RUBINQI/FOC_drv8305-STM32F407/README.md

# FOC_DRV8305&STM32F407
FOC project with AI Coding（vibe coding），use drv8305 to drive NMOS FETS，MCU is STM32F407VET6
PCB is printed by JLC(4 layers)
