RUBINQI/FOC_drv8305-STM32F407/Hardware/pcb/3D_PCB_bottom.png

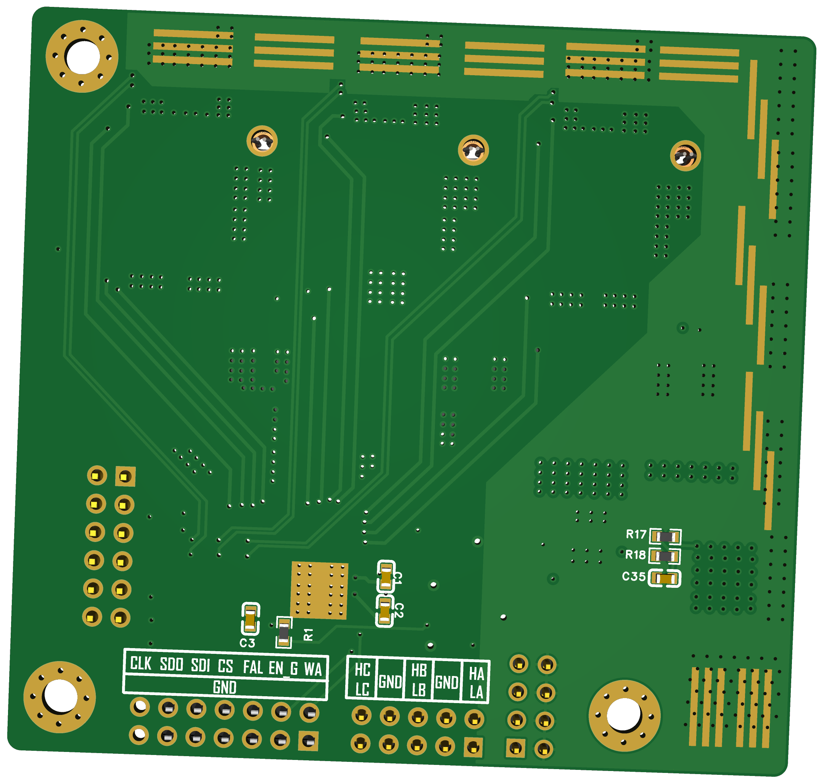
Hardware/pcb/3D_PCB_bottom.png
