RUBINQI/FOC_drv8305-STM32F407/Hardware/pcb/PCB_PCB1_2026-03-12.pdf

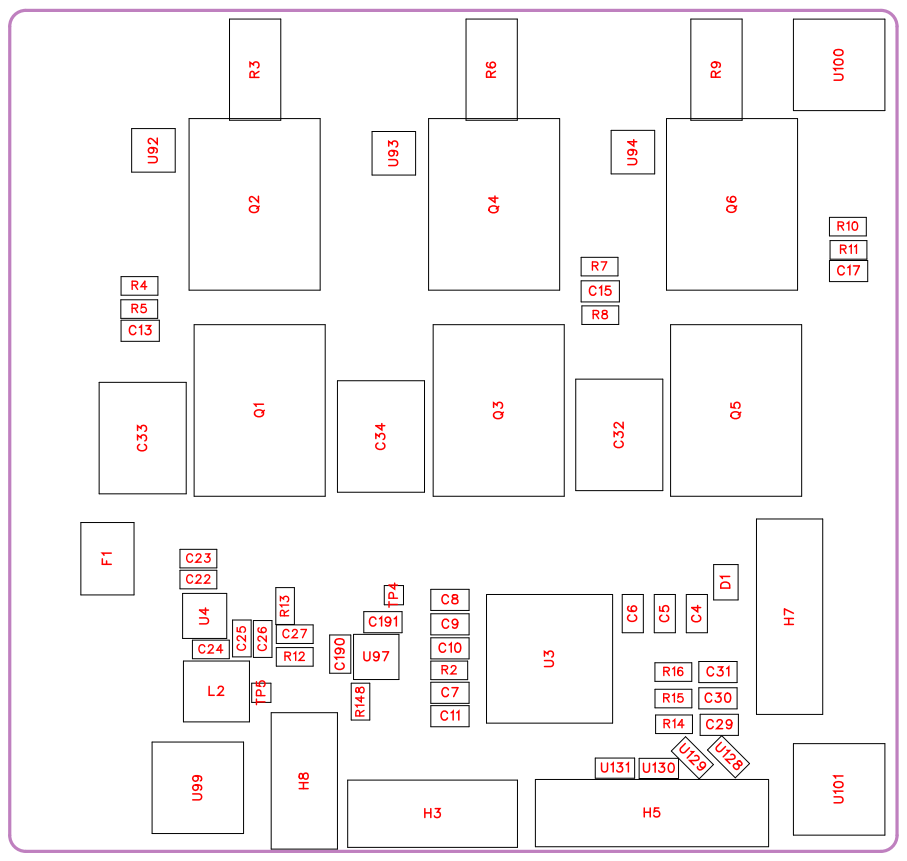
[picture p3: page 1]

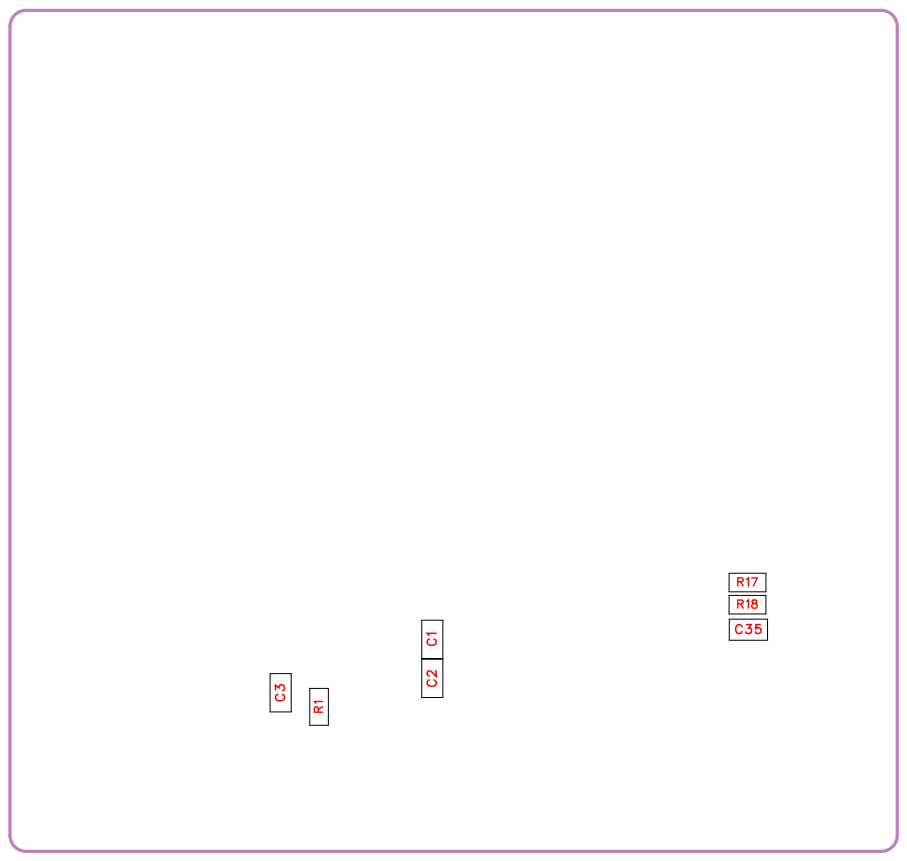
[picture p4: page 2]

No. | Quantity | Comment | Designator | Footprint | Value | Manufacturer Part | Manufacturer | Supplier Part | Supplier
1 | 2 | 470pF | C1,C2 | C0603 | 470pF
2 | 8 | 1uF | C3,C7,C8,C11,C13,C15,C1 7,C35 | C0603 | 1uF
3 | 3 | 1nF | C4,C5,C6 | C0603 | 1nF
4 | 4 | 2.2uF | C9,C29,C30,C31 | C0603 | 2.2uF
5 | 1 | 4.7uF | C10 | C0603 | 4.7uF
6 | 2 | 22u | C22,C26 | C0603
7 | 3 | 100n | C23,C24,C25 | C0603
8 | 1 | 220p | C27 | C0603
9 | 3 | 固态电容220 uF/10V6.3*5. 4 | C32,C33,C34 | CAP-SMD_B D6.3-L6.6-W 6.6-LS7.2-FD | | 固态电容220 uF/10V6.3*5. 4 | | C990000173 6 | LCSC
10 | 2 | 1u | C190,C191 | C0603 | 1u
11 | 1 | TPD4E02B0 4QDQARQ1 | D1 | USON-10_L2 .5-W1.0-P0.5 0-BL | | TPD4E02B0 4QDQARQ1 | TI(德州仪器) | C1973193 | LCSC
12 | 1 | BSMD1812-2 00-30V | F1 | F1812 | | BSMD1812-2 00-30V | BHFUSE(佰 宏) | C960026 | LCSC
13 | 1 | HDR-F_2.54 _2x5 | H3 | HDR-TH_10 P-P2.54-V-F-R2-C5-S2.54 | | | | C92270
14 | 1 | HDR-F_2.54 _2x7 | H5 | HDR-TH_14 P-P2.54-V-F-R2-C6-S2.54 | | | | C36191
15 | 1 | HDR-F_2.54 _2x6 | H7 | HDR-TH_12 P-P2.54-V-M -R2-C6-S2.5 4
16 | 1 | HDR-F_2.54 _2x4 | H8 | HDR-TH_8P-P2.54-V-F-R 2-C4-S2.54-1 | | | | C92271
17 | 1 | 4.7uH | L2 | IND-SMD_L4 .6-W4.2_042 0_4.7UH | 4.7uH
18 | 6 | HYG006N04 LS1TA | Q1,Q2,Q3,Q4,Q5,Q6 | TOLL-8_L10. 4-W9.9-P1.2 0-LS11.7-BL | | HYG006N04 LS1TA | HUAYI(华羿 微) | C2982928 | LCSC
19 | 1 | 10K | R1 | R0603 | 10K
20 | 1 | 100 | R2 | R0603 | 100
21 | 3 | 10m | R3,R6,R9 | R2512 | 10m | RLM25FEER 010 | 大毅科技 | C192580 | LCSC
22 | 4 | 24.9k | R4,R7,R10,R17 | R0603 | 24.9k
23 | 4 | 4.99k | R5,R8,R11,R18 | R0603 | 4.99k
24 | 1 | 73.2k | R12 | R0603
25 | 1 | 10k | R13 | R0603

26 | 3 | 56 | R14,R15,R16 | R0603 | 56
27 | 1 | 100k | R148 | R0603 | 100k
28 | 2 | 测试点 | TP4,TP5 | TP
29 | 1 | DRV83053Q PHPRQ1 | U3 | HTQFP-48_L 7.0-W7.0-P0. 50-LS9.0-BL-EP5.1 | | DRV83053Q PHPRQ1 | TI(德州仪器 ) | C701777 | LCSC
30 | 1 | RY9121 | U4 | TSOT-23-6_ L2.9-W1.6-P 0.95-LS2.8-B R | | RY9121 | RYCHiP(蕊源 ) | C2887854 | LCSC
31 | 3 | TP-黄色测试 点 | U92,U93,U94 | TESTPOINT-TH_BD3.2 | | TP-黄色测试 点 | | C990000742 2 | LCSC
32 | 1 | RT9013 | U97 | RT9013
33 | 3 | 定位孔 | U99,U100,U101 | M3定位孔
34 | 4 | 测试环5015 | U128,U129,U130,U131 | 测试环5015

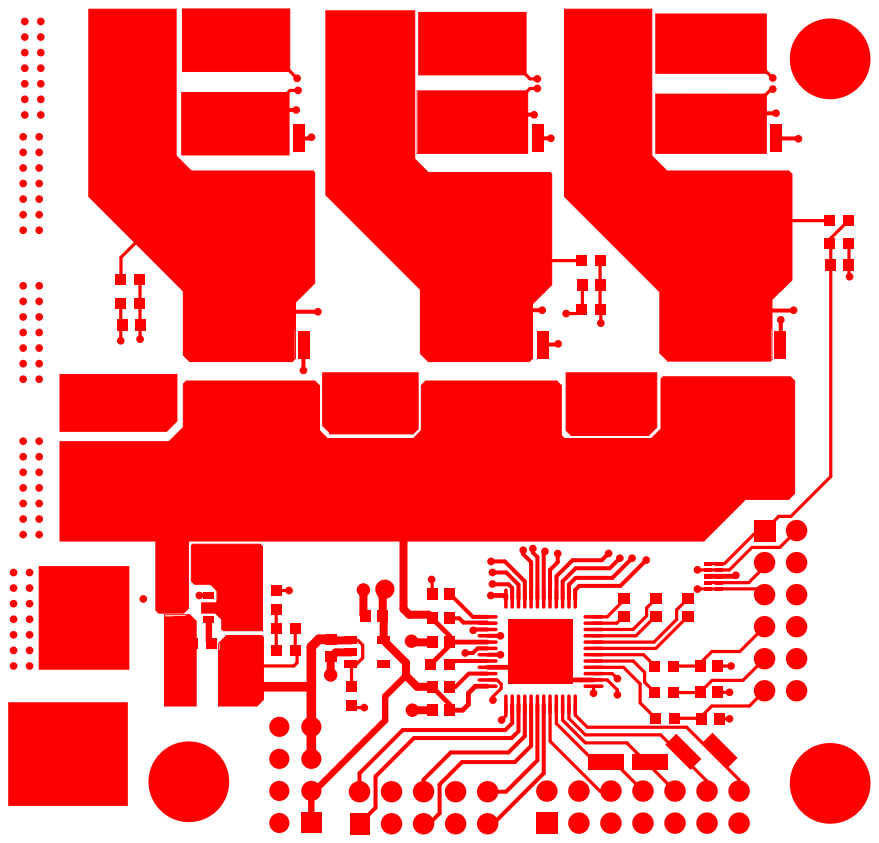
[picture p5: page 5]

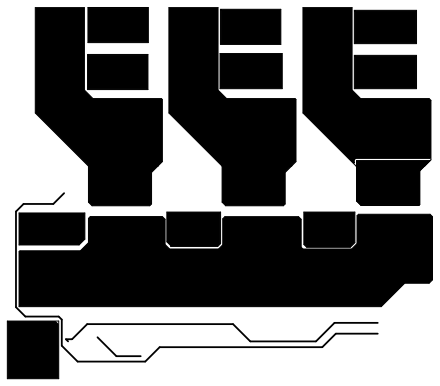
[picture p6: figure]
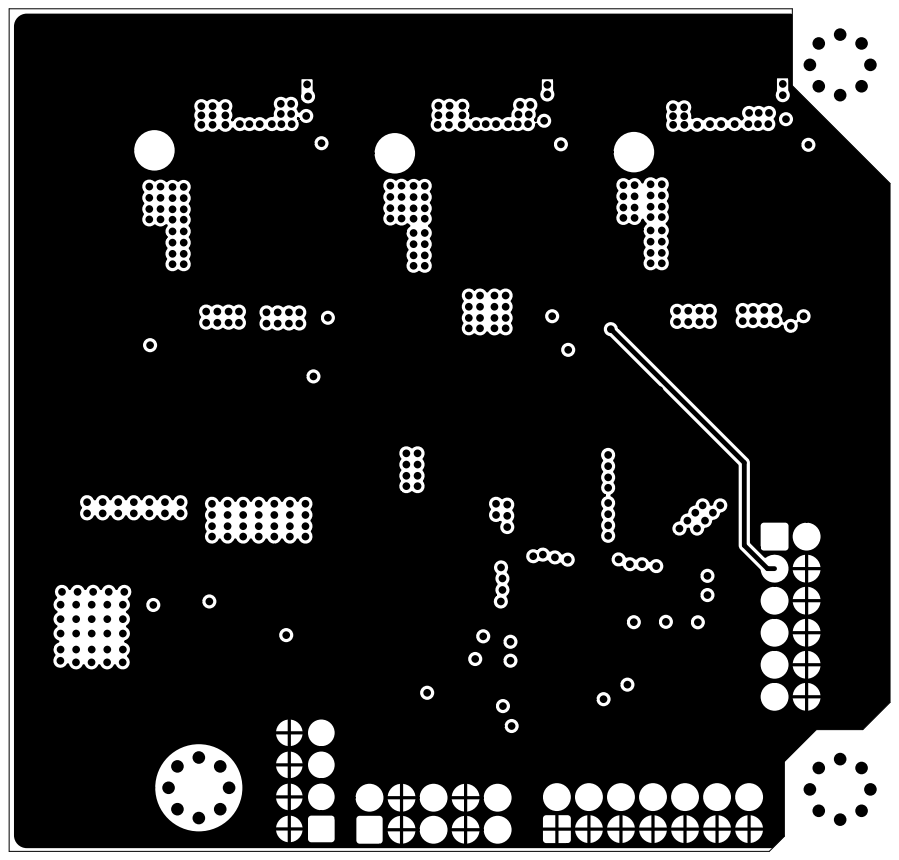
[picture p7: page 7]

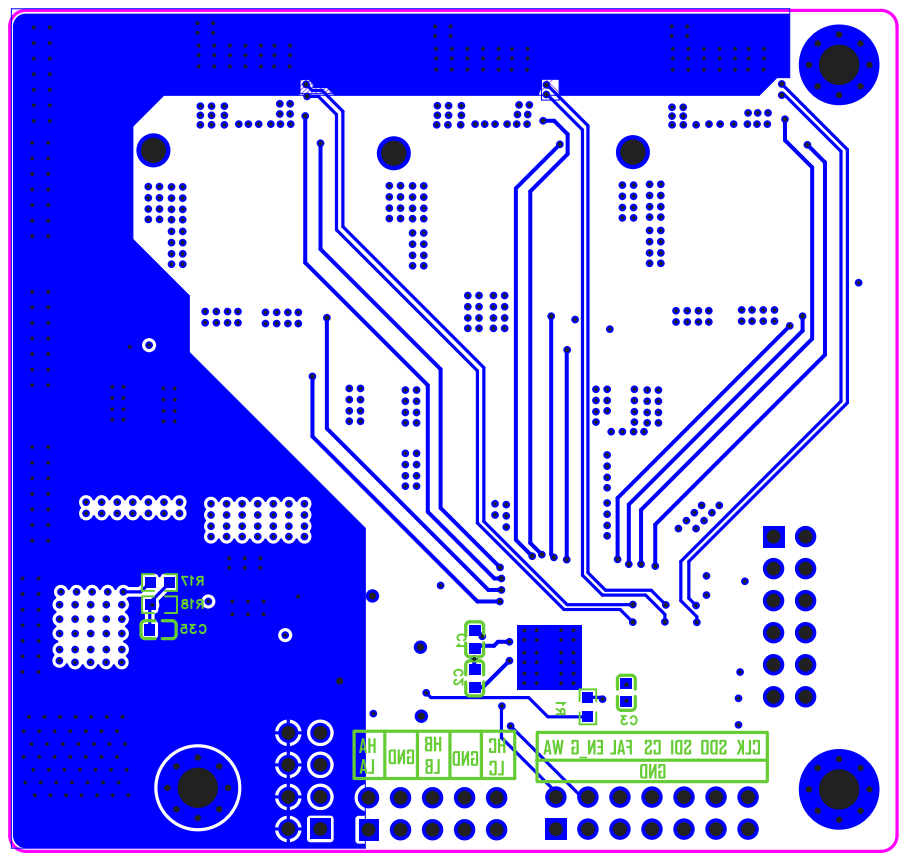
[picture p8: page 8]

WA EN_G FAL CS SDI SDO CLK

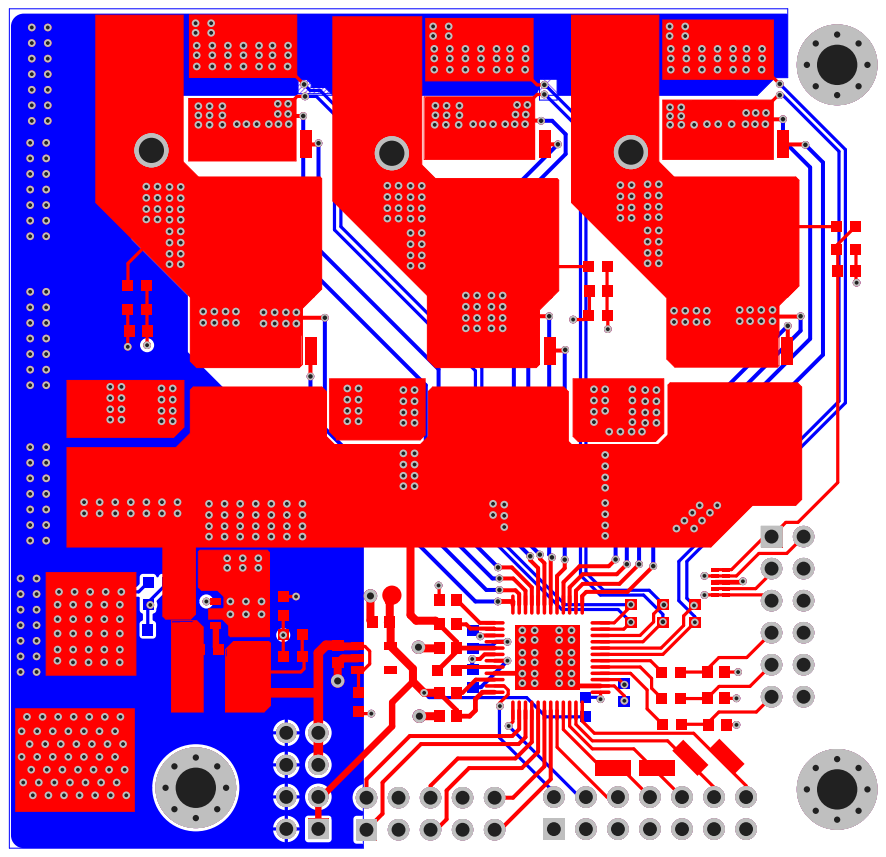
[picture p9: page 9]
