RUBINQI/FOC_drv8305-STM32F407/Hardware/sch/SCH_Schematic1_2026-03-12.pdf

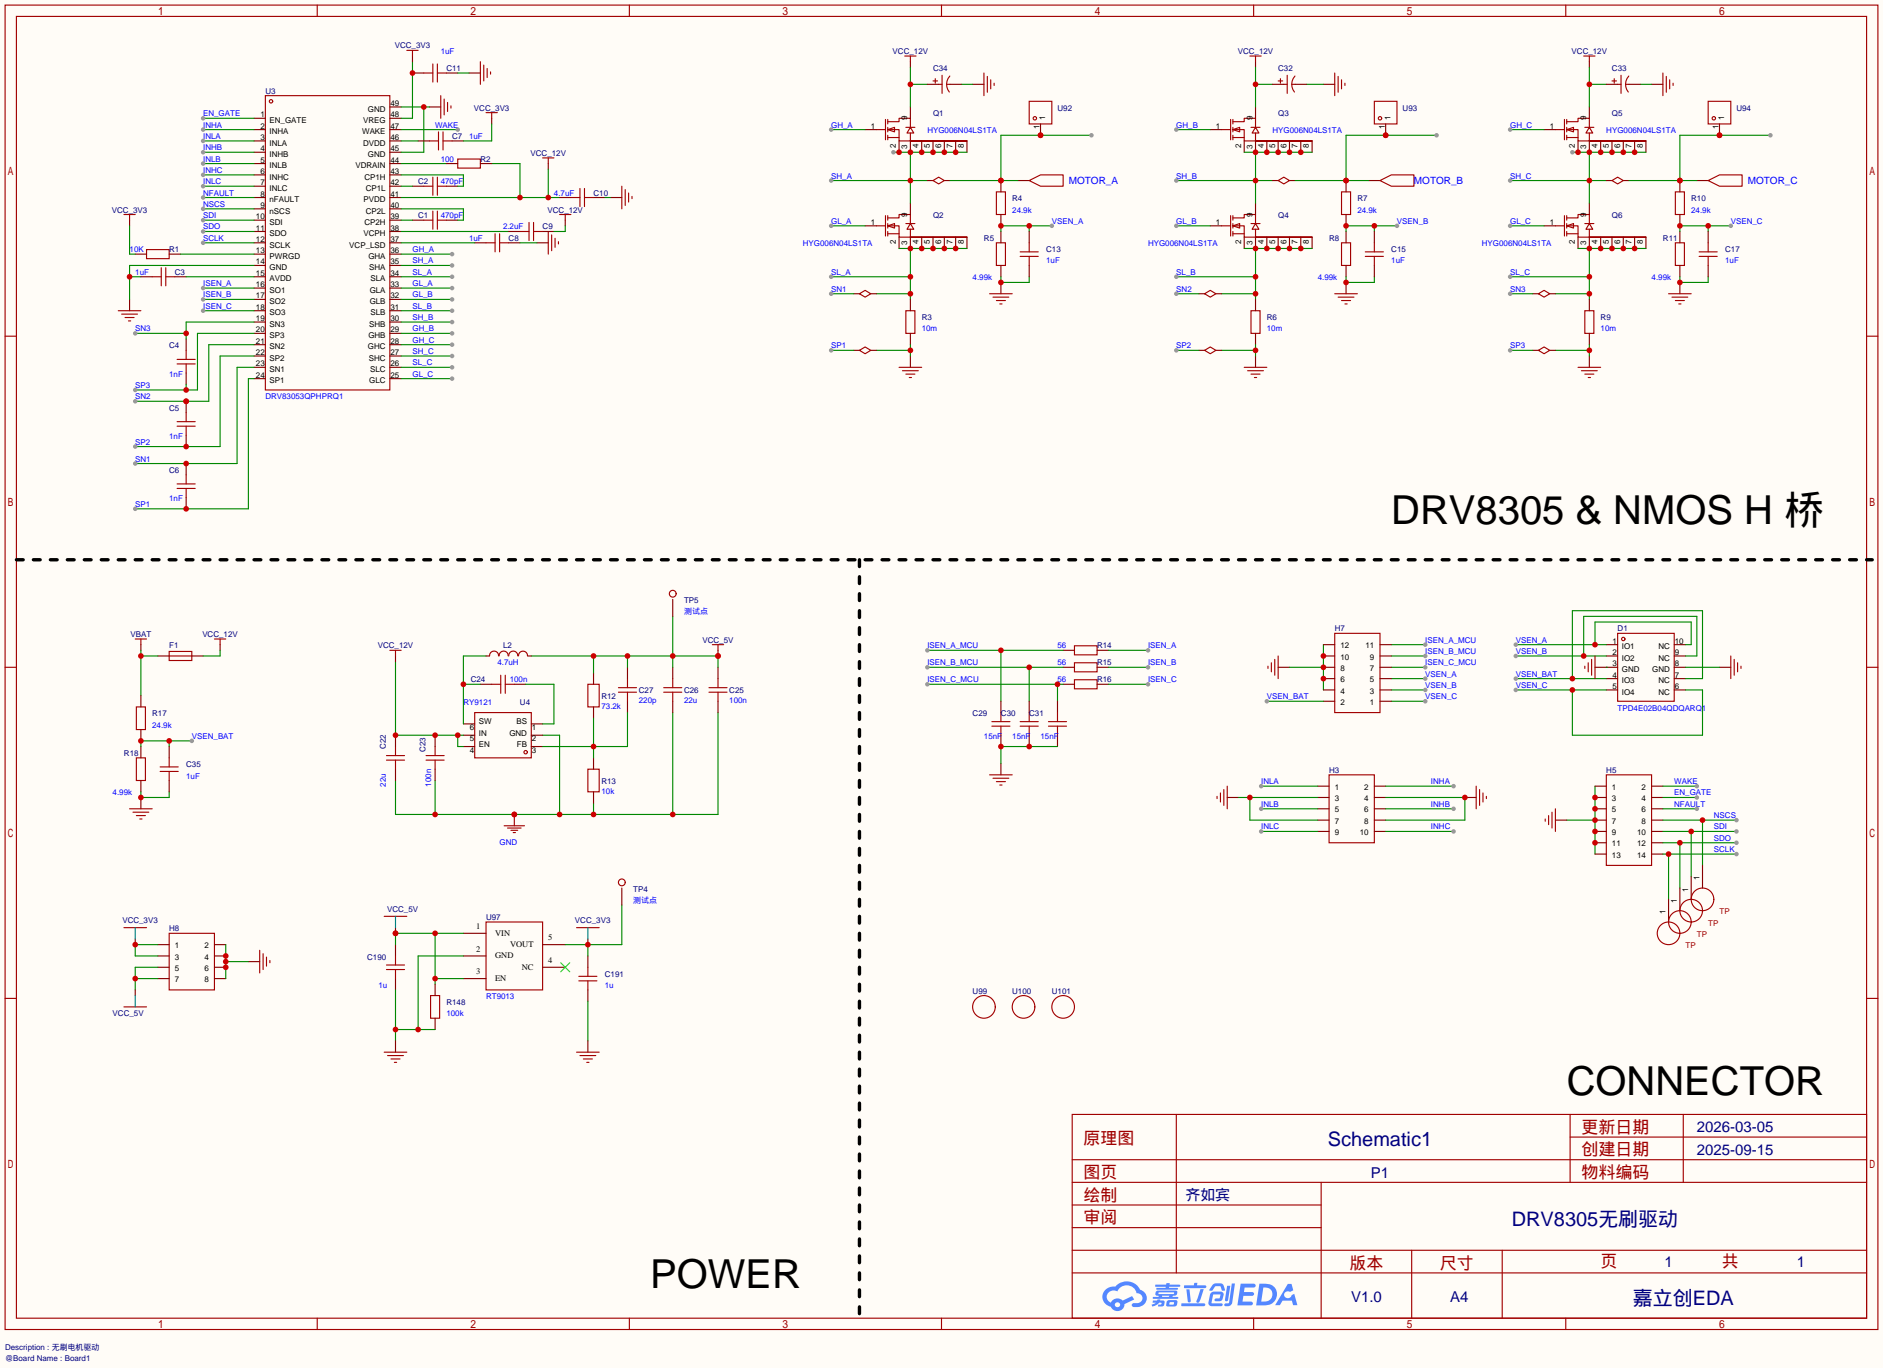
[picture p10: page 1]
