RUBINQI/FOC_drv8305-STM32F407/FOC_stm32f4_as5600_drv8305.ioc

Mcu.UserName=STM32F407VETx
PA0-WKUP.GPIO_Label=nFAULT
PA0-WKUP.Signal=GPXTI0
PA1.GPIO_Label=WAKE
PA1.Signal=GPIO_Output
PA10.Signal=USART1_RX
PA13.Signal=SYS_JTMS-SWDIO
PA14.Signal=SYS_JTCK-SWCLK
PA2.GPIO_Label=EN_GATE
PA2.Signal=GPIO_Output
PA4.GPIO_Label=DRV8305_CS
PA4.Signal=GPIO_Output
PA5.GPIO_Label=DRV8305_SCK
PA5.Signal=SPI1_SCK
PA6.GPIO_Label=DRV8305_MISO
PA6.Signal=SPI1_MISO
PA7.GPIO_Label=DRV8305_MOSI
PA7.Signal=SPI1_MOSI
PA9.Signal=USART1_TX
PB0.Signal=TIM1_CH2N
PB1.Signal=TIM1_CH3N
PB6.GPIO_Label=AS5600_SCL
PB6.Signal=I2C1_SCL
PB7.GPIO_Label=AS5600_SDA
PB7.Signal=I2C1_SDA
PC0.GPIO_Label=I_A
PC0.Signal=ADCx_IN10
PC1.GPIO_Label=I_B
PC1.Signal=ADCx_IN11
PC2.GPIO_Label=I_C
PC2.Signal=ADCx_IN12
PC3.GPIO_Label=AS5600_ANGLE
PC3.Signal=ADCx_IN13
PD10.GPIO_Label=LED_RED
PD10.Signal=GPIO_Output
PD11.GPIO_Label=LED_GREEN
PD11.Signal=GPIO_Output
PD9.GPIO_Label=LED_BLUE
PD9.Signal=GPIO_Output
PE11.Signal=S_TIM1_CH2
PE13.Signal=S_TIM1_CH3
PE2.GPIO_Label=BEEP
PE2.Signal=GPIO_Output
PE8.Signal=TIM1_CH1N
PE9.Signal=S_TIM1_CH1
PH0-OSC_IN.Signal=RCC_OSC_IN
PH1-OSC_OUT.Signal=RCC_OSC_OUT
